sdsmt-robotics/Controller/README.md

# ARCHIVED. USE GITLAB.

# Controller
Repo is used to document all the iterations for the controller
