sdsmt-robotics/Controller/Eagle/Board.pdf

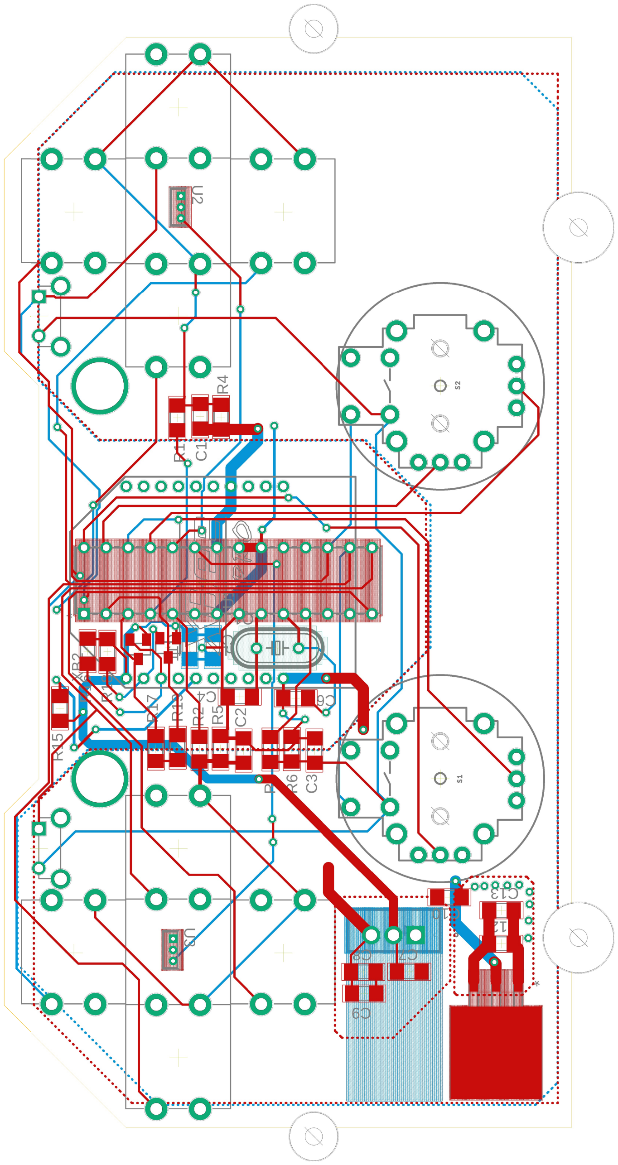
[picture p1: figure]
