sdsmt-robotics/Controller/3D/12x12 - Colored.PNG

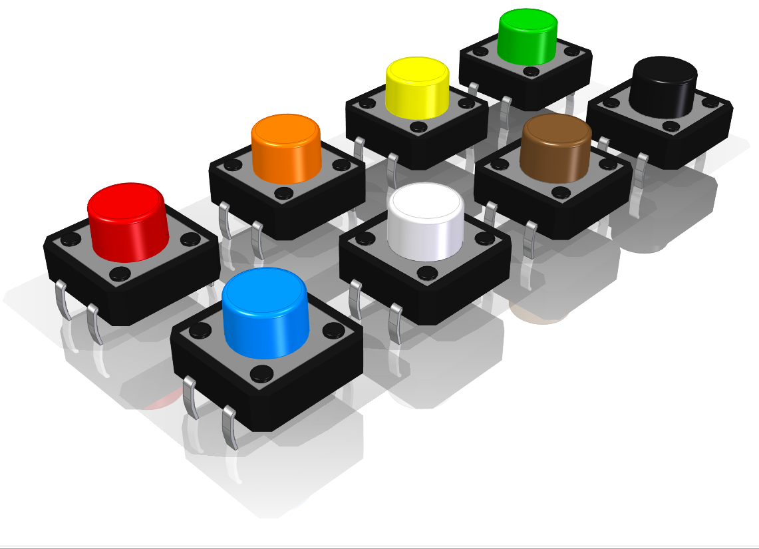
3D/12x12 - Colored.PNG
