sdsmt-robotics/Controller/2019-10-24_21-24-13/STEP/TS3B-L.step

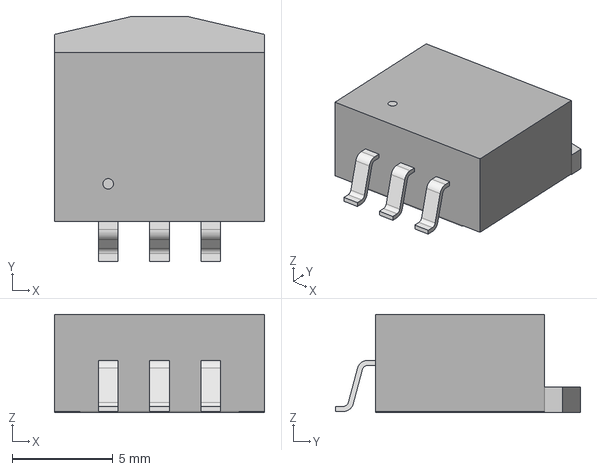
[picture p3: CAD file, 2019-10-24]
2019-10-24_21-24-13/STEP/TS3B-L.step
10.4 x 12.1 x 4.85 mm
