sdsmt-robotics/Controller/3D/Tactal Switch - THRU(12mmx12mmx8mm)-Brown.stp

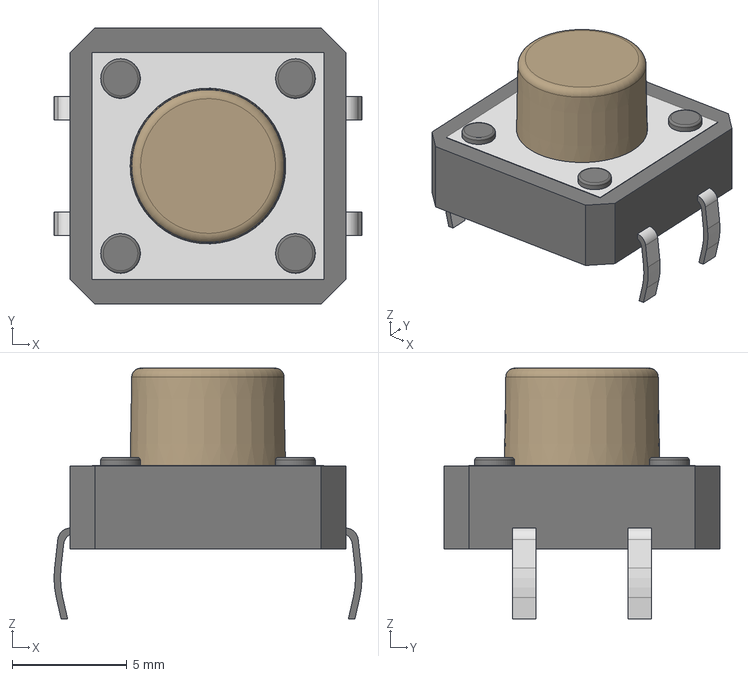
[picture p4: CAD file, 2019-10-19]
3D/Tactal Switch - THRU(12mmx12mmx8mm)-Brown.stp
13.4 x 12.0 x 10.9 mm
