sdsmt-robotics/Controller/3D/BSS138_D87Z--3DModel-STEP-56544.STEP

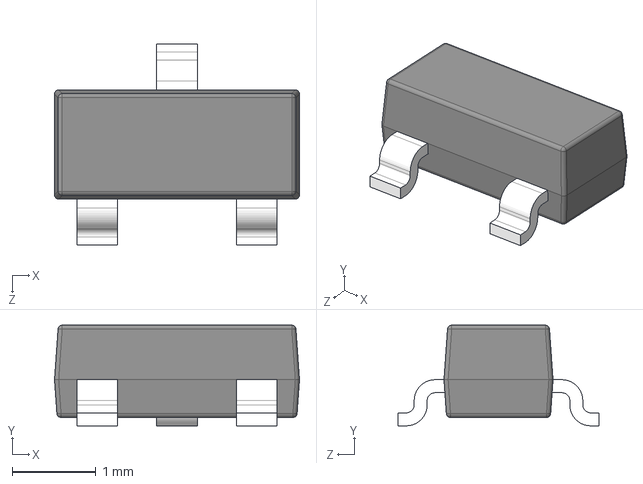
[picture p5: CAD file, 2019-10-19]
3D/BSS138_D87Z--3DModel-STEP-56544.STEP
2.92 x 1.20 x 2.40 mm
