sdsmt-robotics/Controller/3D/XBee Pro 60mW.STEP

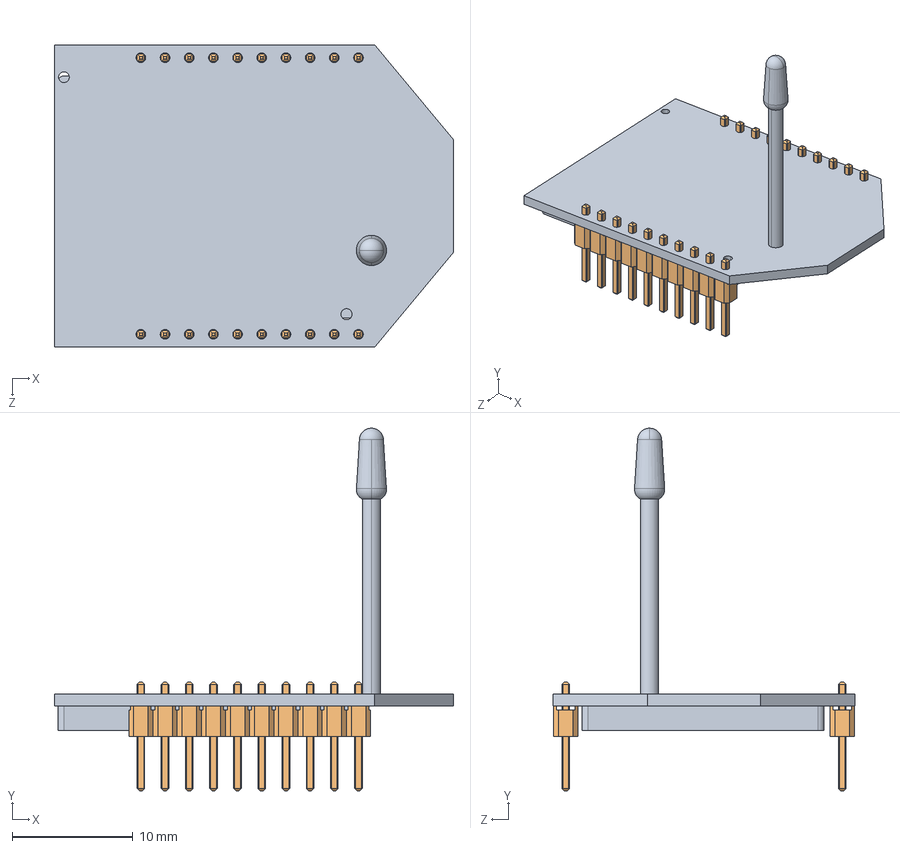
[picture p6: CAD file, 2019-10-19]
3D/XBee Pro 60mW.STEP
33.0 x 30.0 x 25.0 mm
XBee Pro 60mW PCB
10x Pinheader Male x 2
