sdsmt-robotics/Controller/3D/RKJXV1224005.STEP

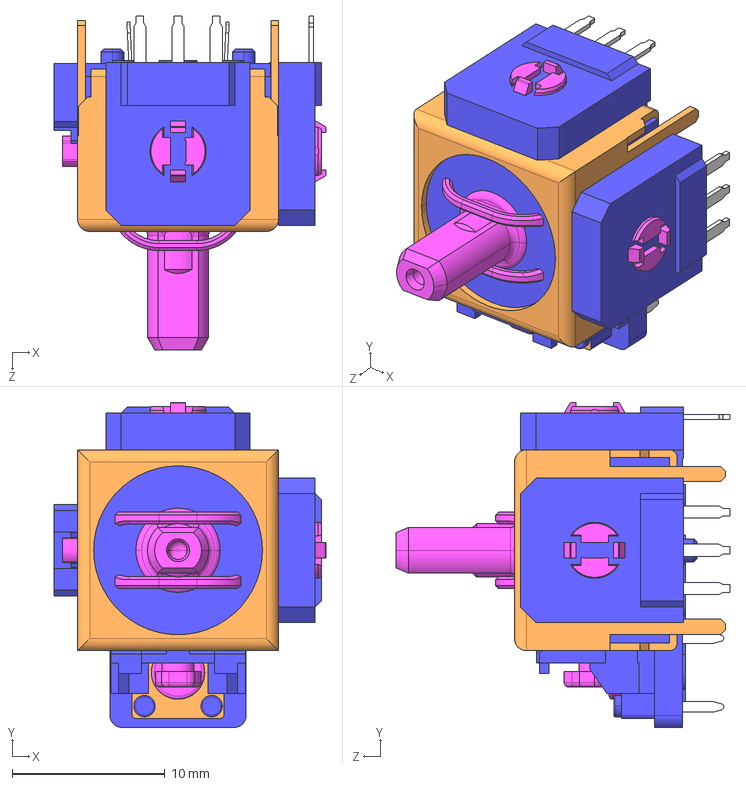
[picture p7: CAD file, 2019-10-11]
3D/RKJXV1224005.STEP
17.8 x 21.3 x 21.9 mm
