sdsmt-robotics/Controller/(list of files, cad)

Other CAD files:
2019-10-24_21-24-13/STEP/TS3B.step
2019-10-24_21-24-13/STEP/TS3B-M.step
3D/Tactal Switch - THRU(12mmx12mmx8mm)-Blue.stp
3D/Tactal Switch - THRU(12mmx12mmx8mm)-Green.stp
3D/Tactal Switch - THRU(12mmx12mmx8mm)-White.stp
3D/Tactal Switch - THRU(12mmx12mmx8mm)-Black.stp
3D/Tactal Switch - THRU(12mmx12mmx8mm)-Orange.stp
3D/Tactal Switch - THRU(12mmx12mmx8mm)-Red.stp
3D/Tactal Switch - THRU(12mmx12mmx8mm)-Yellow.stp
