sdsmt-robotics/Controller/Eagle/Schematic.pdf

A

A

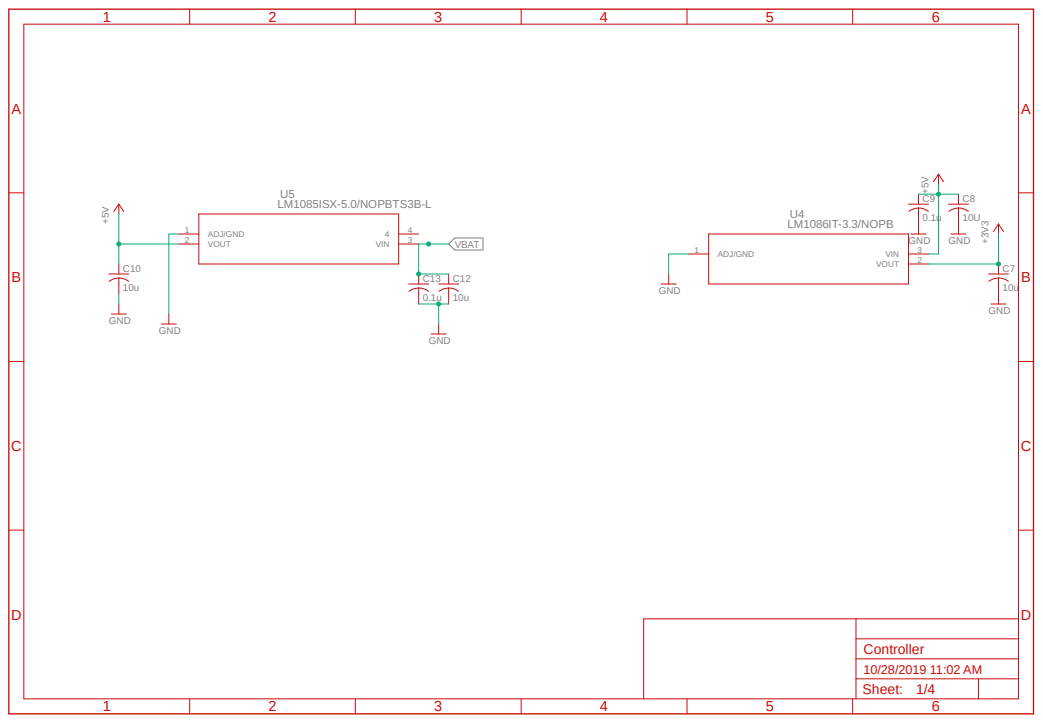
[picture p8: page 1]

## ATMEGA328-PU +5V

A

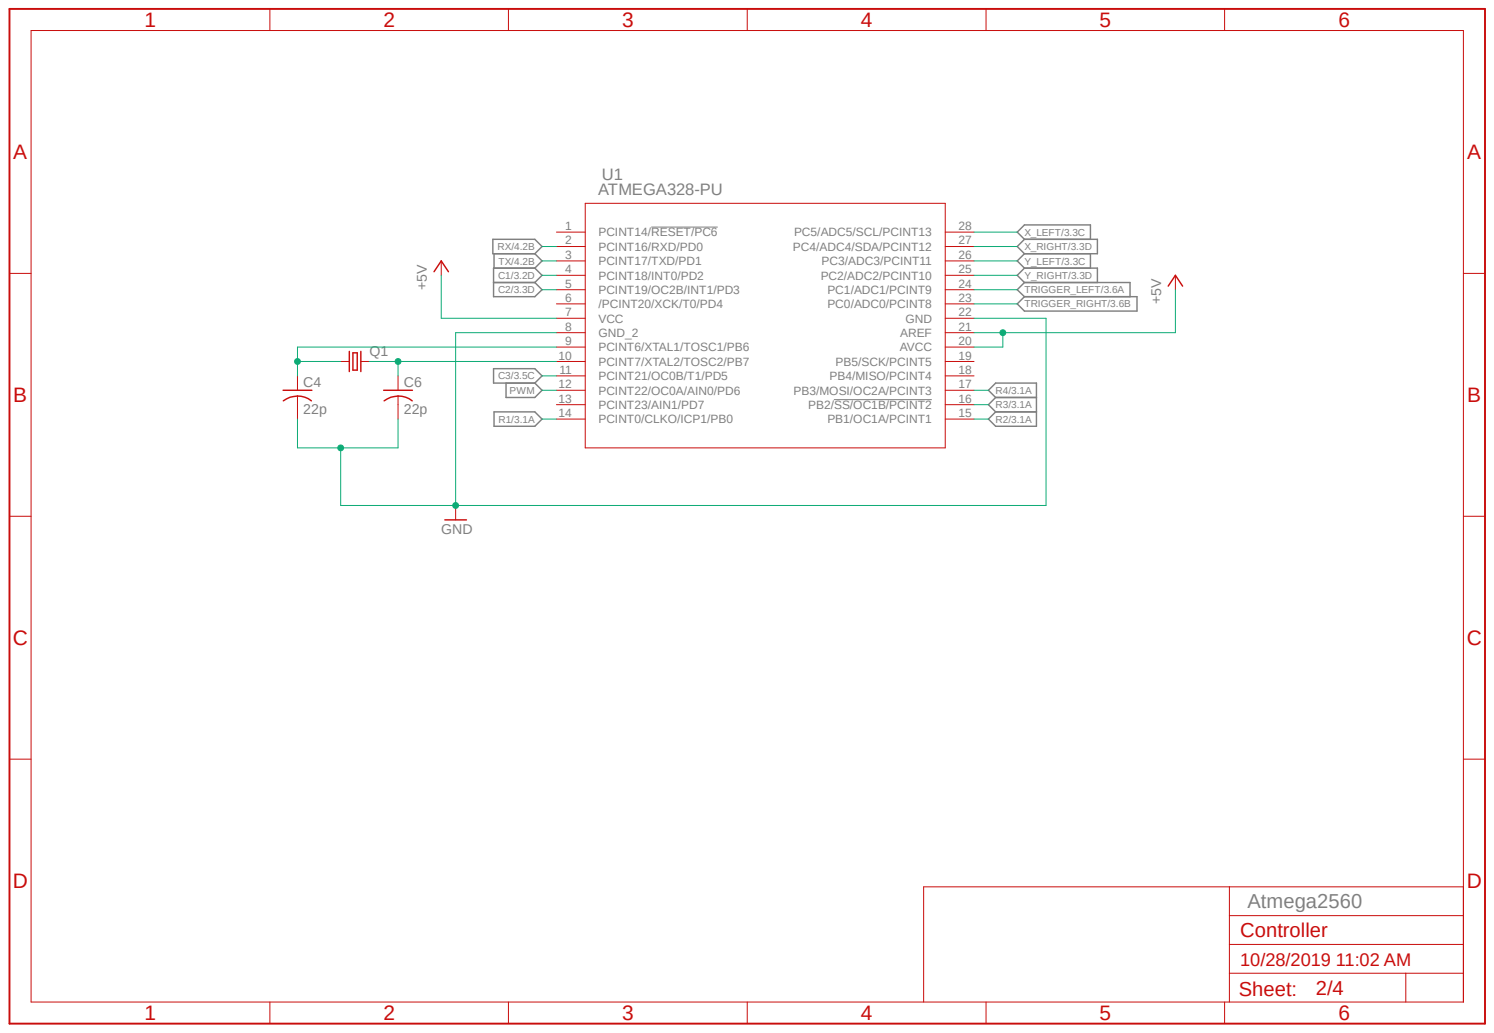
[picture p9: page 2]
Atmega2560; GND; PCINT14/RESET/PC6 1; PCINT16/RXD/PD0 2; PCINT17/TXD/PD1 3; PCINT18/INT0/PD2 4; PCINT19/OC2B/INT1/PD3 5; /PCINT20/XCK/T0/PD4 6; VCC 7; GND_2 8; PCINT6/XTAL1/TOSC1/PB6 9; PCINT7/XTAL2/TOSC2/PB7 10; PCINT21/OC0B/T1/PD5 11; PCINT22/OC0A/AIN0/PD6 12; PCINT23/AIN1/PD7 13; PCINT0/CLKO/ICP1/PB0 14; PB1/OC1A/PCINT1; 15 PB2/SS/OC1B/PCINT2; 16 PB3/MOSI/OC2A/PCINT3; 17 PB4/MISO/PCINT4; 18 PB5/SCK/PCINT5; 19 AVCC; 20 AREF; 21 GND; 22 PC0/ADC0/PCINT8; 23 PC1/ADC1/PCINT9; 24 PC2/ADC2/PCINT10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

## DRV5053VAQLPGM

## DRV5053VAQLPGM ⁺⁵V +5V

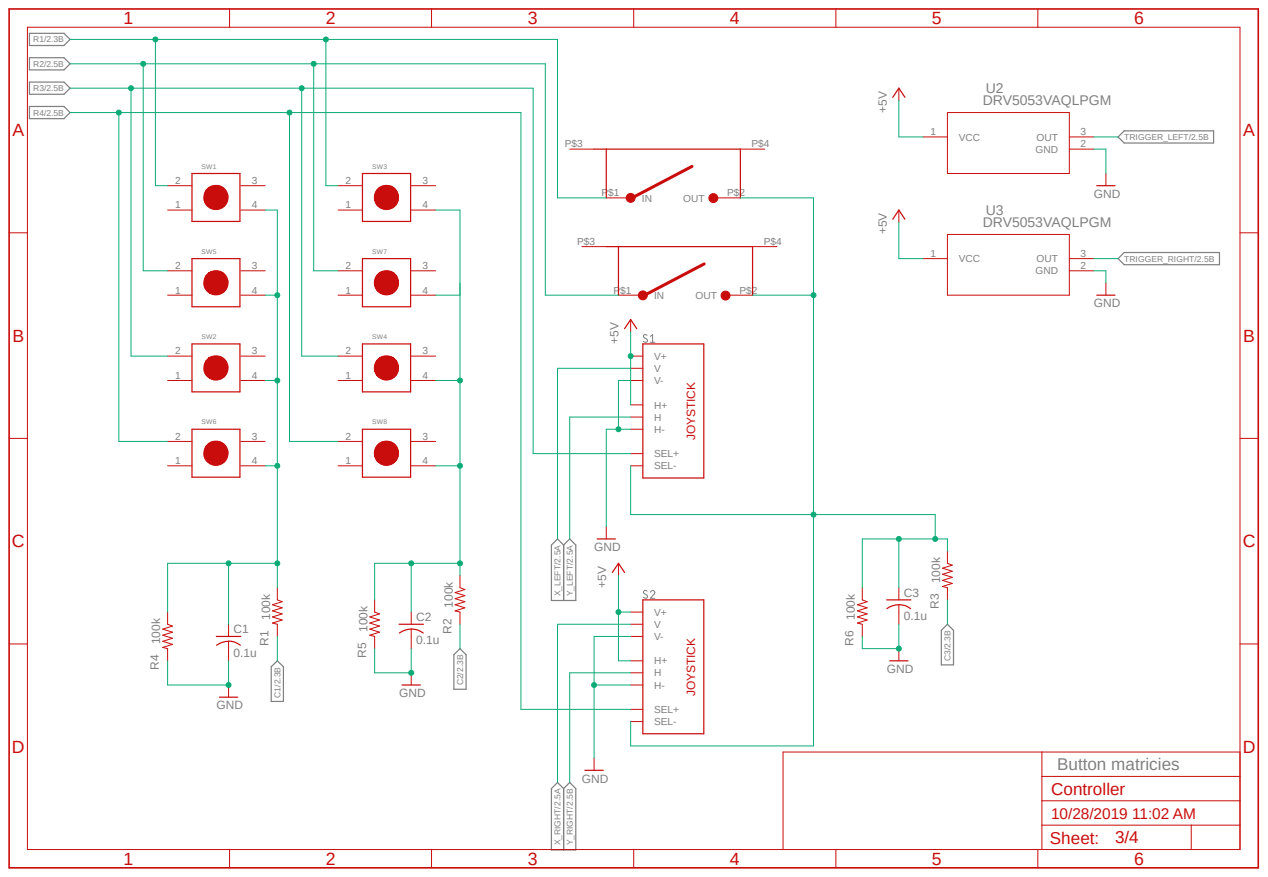
[picture p10: page 3]

Sheet: ABCD | 1 | 2 | 3 | 4 | 5 | 6 | ABCD 1 | 2 | 3 | 4 | 5 | 6

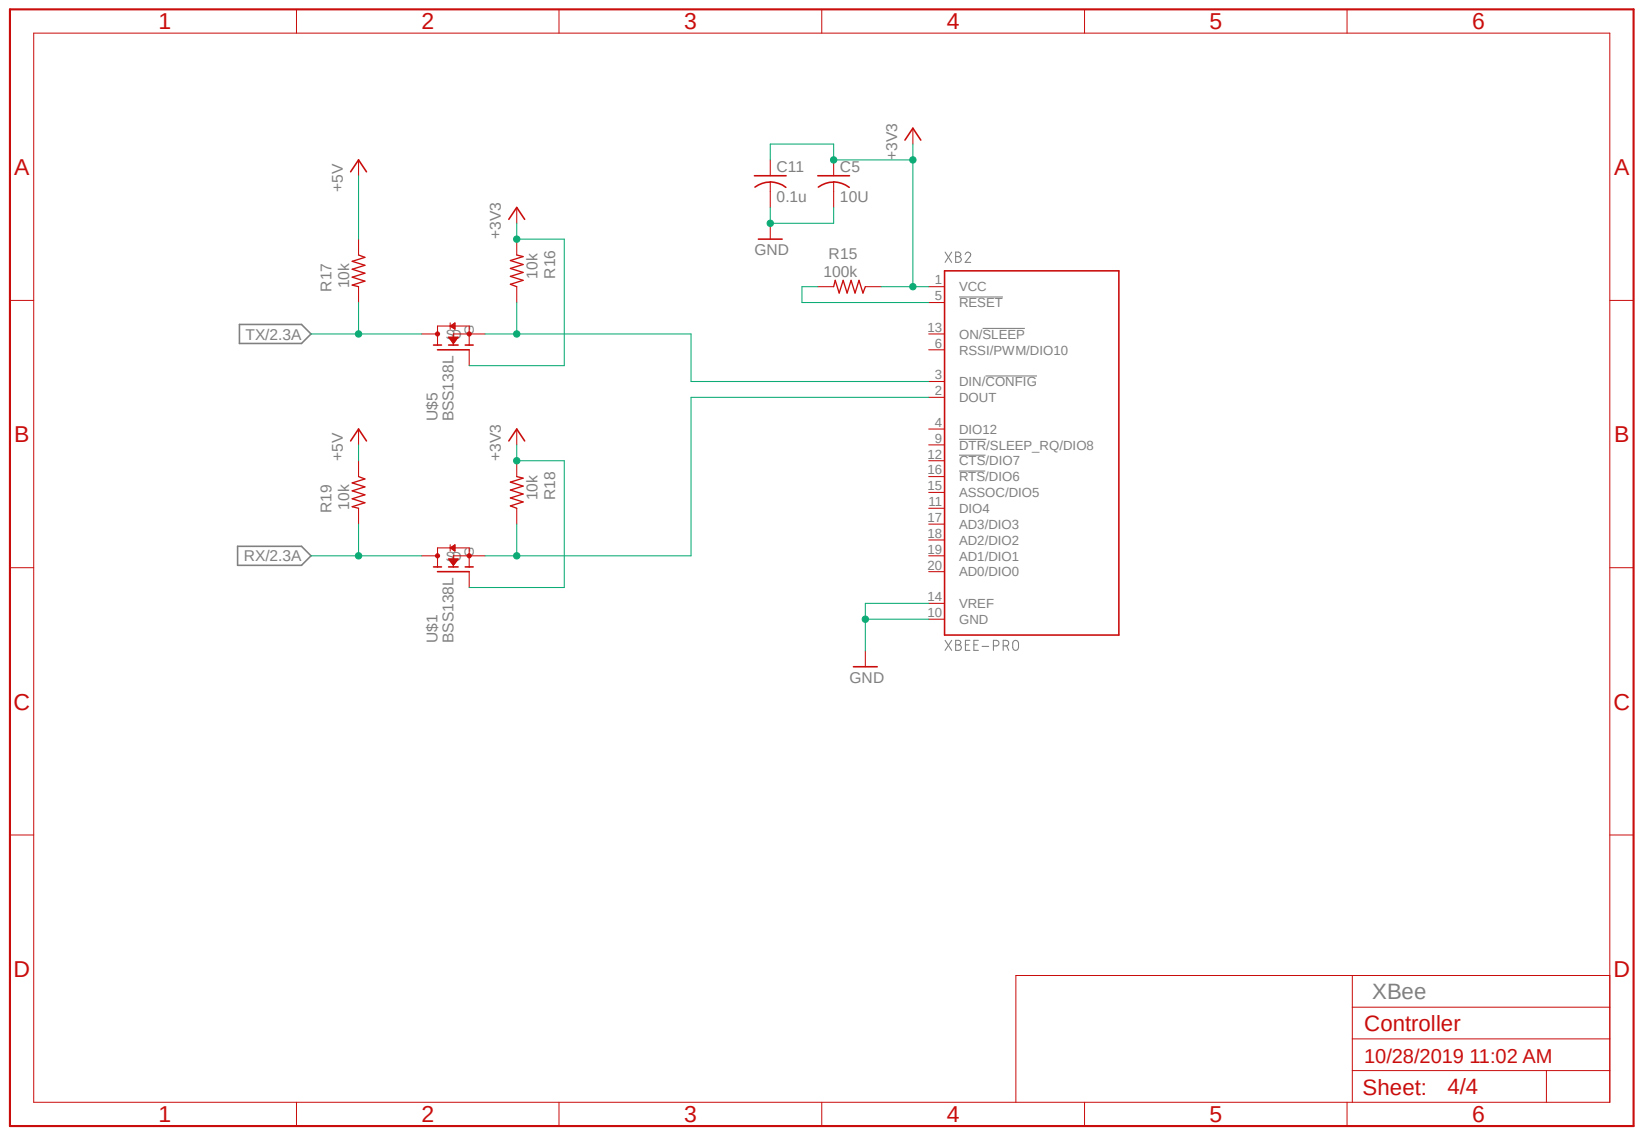
[picture p11: page 4]
XBee; +3V³ BSS¹³⁸L; BSS¹³⁸L; GND; VCC 1; DOUT 2; DIN/CONFIG 3; DIO12 4; RESET 5; RSSI/PWM/DIO10 6; DTR/SLEEP_RQ/DIO8 9; GND 10; DIO4 11; CTS/DIO7 12; ON/SLEEP 13; VREF 14; ASSOC/DIO5 15; RTS/DIO6 16; AD3/DIO3 17; AD2/DIO2 18; AD1/DIO1 19; AD0/DIO0 20; R¹⁶ R¹⁷; R¹⁸ R¹⁹; Controller
