sdsmt-robotics/Controller/Controller.pdf

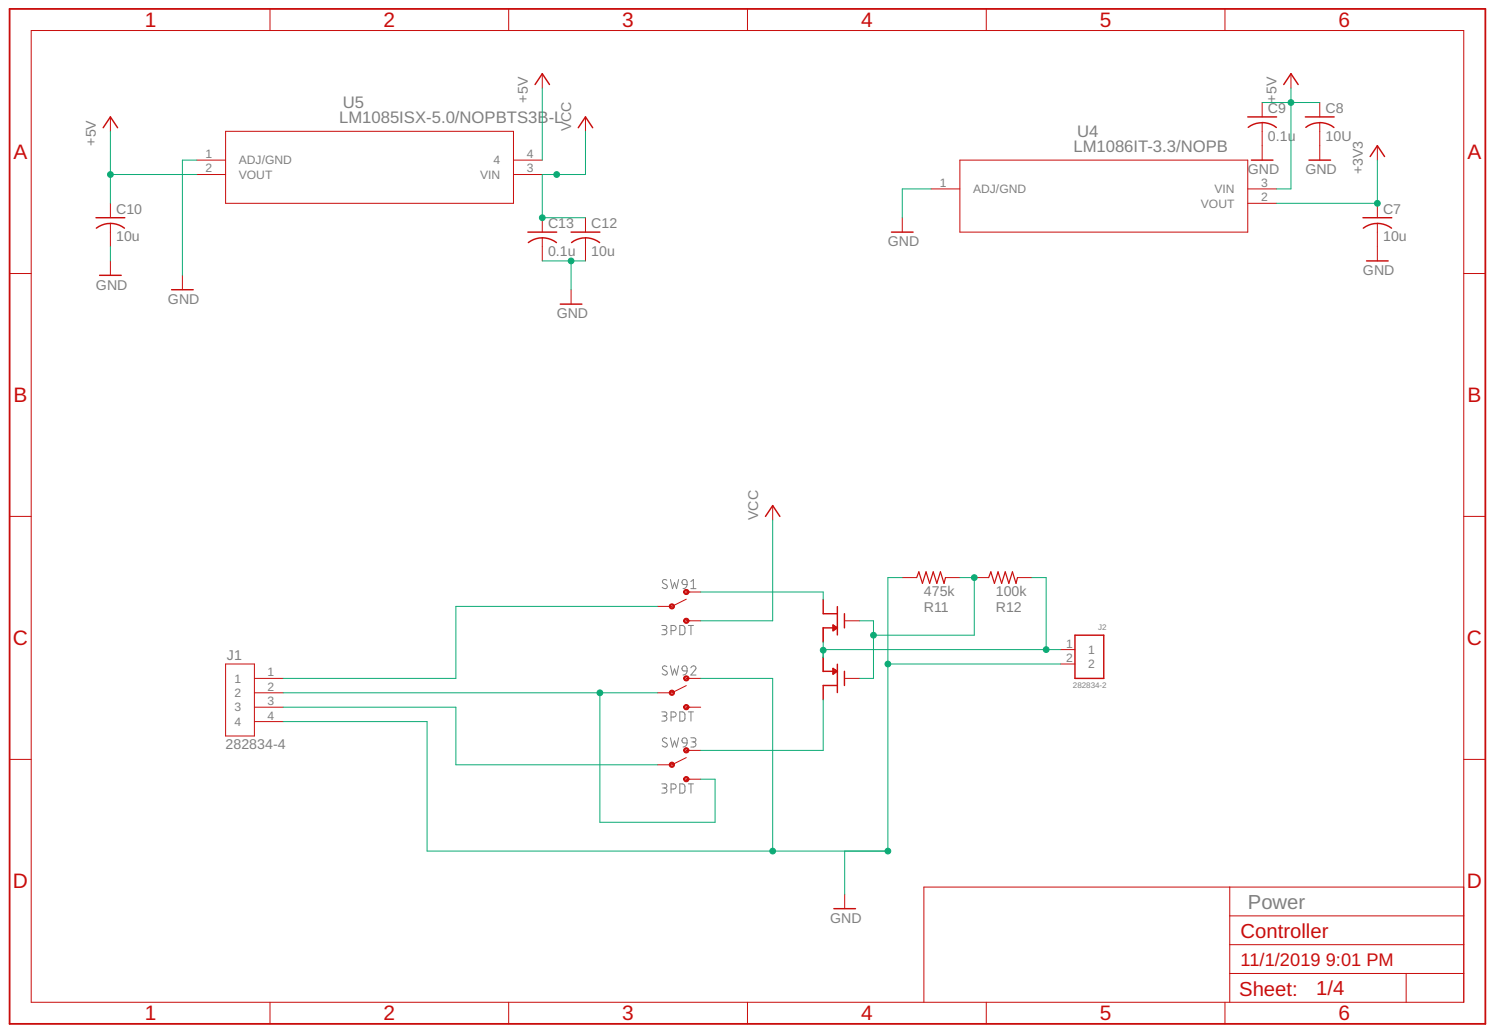
[picture p12: page 1]

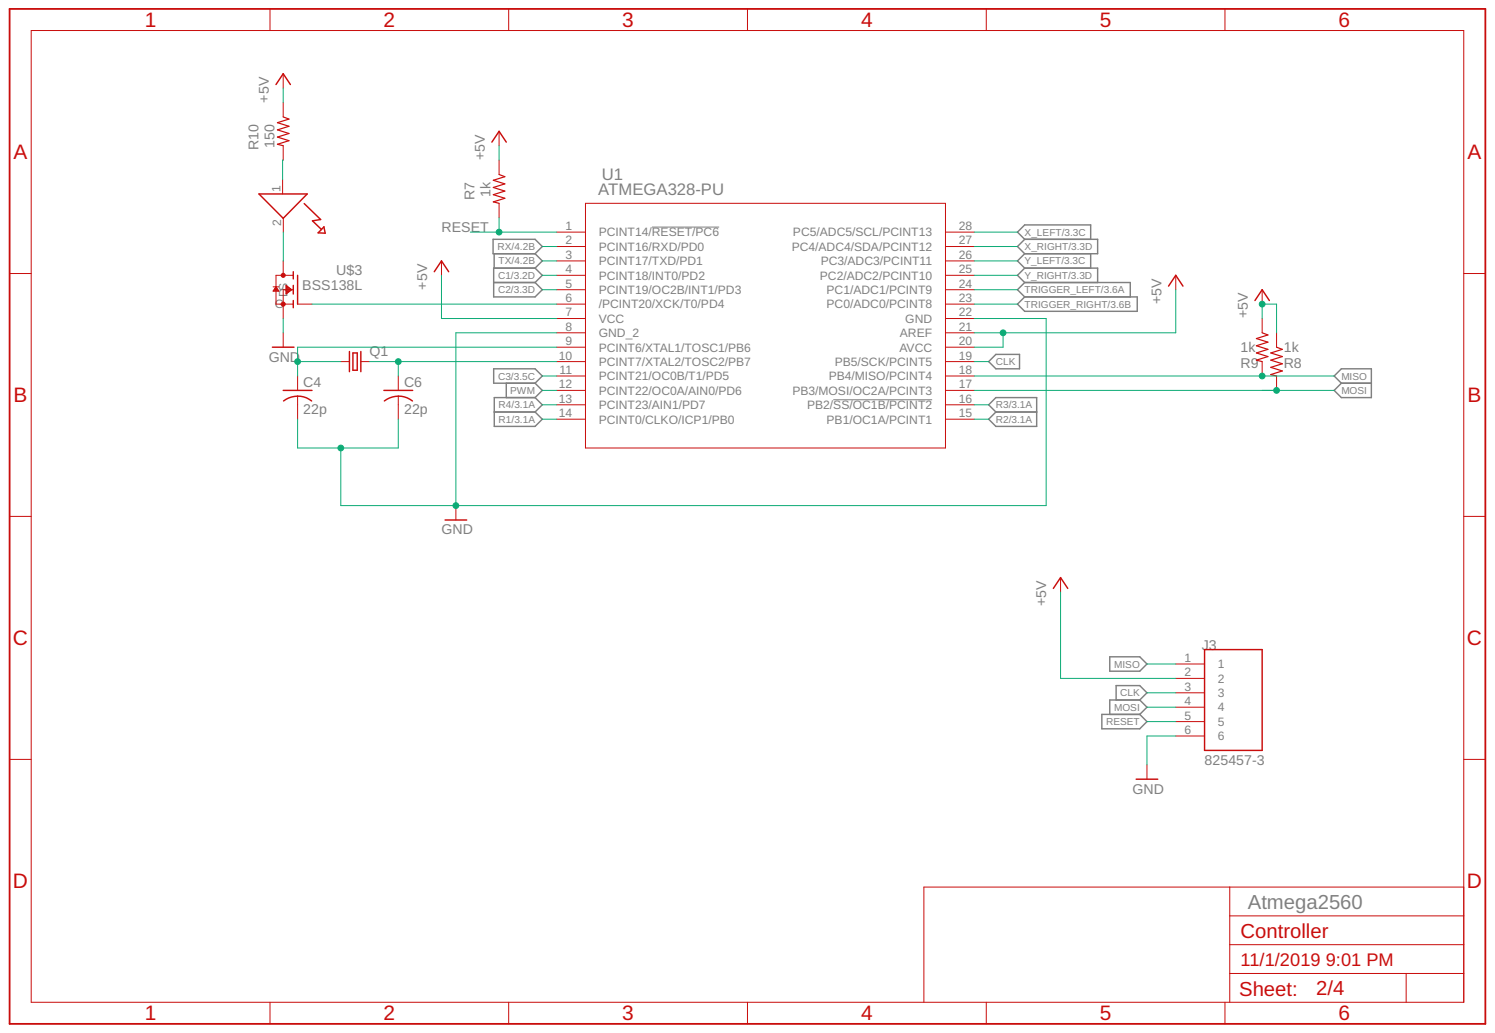
[picture p13: page 2]

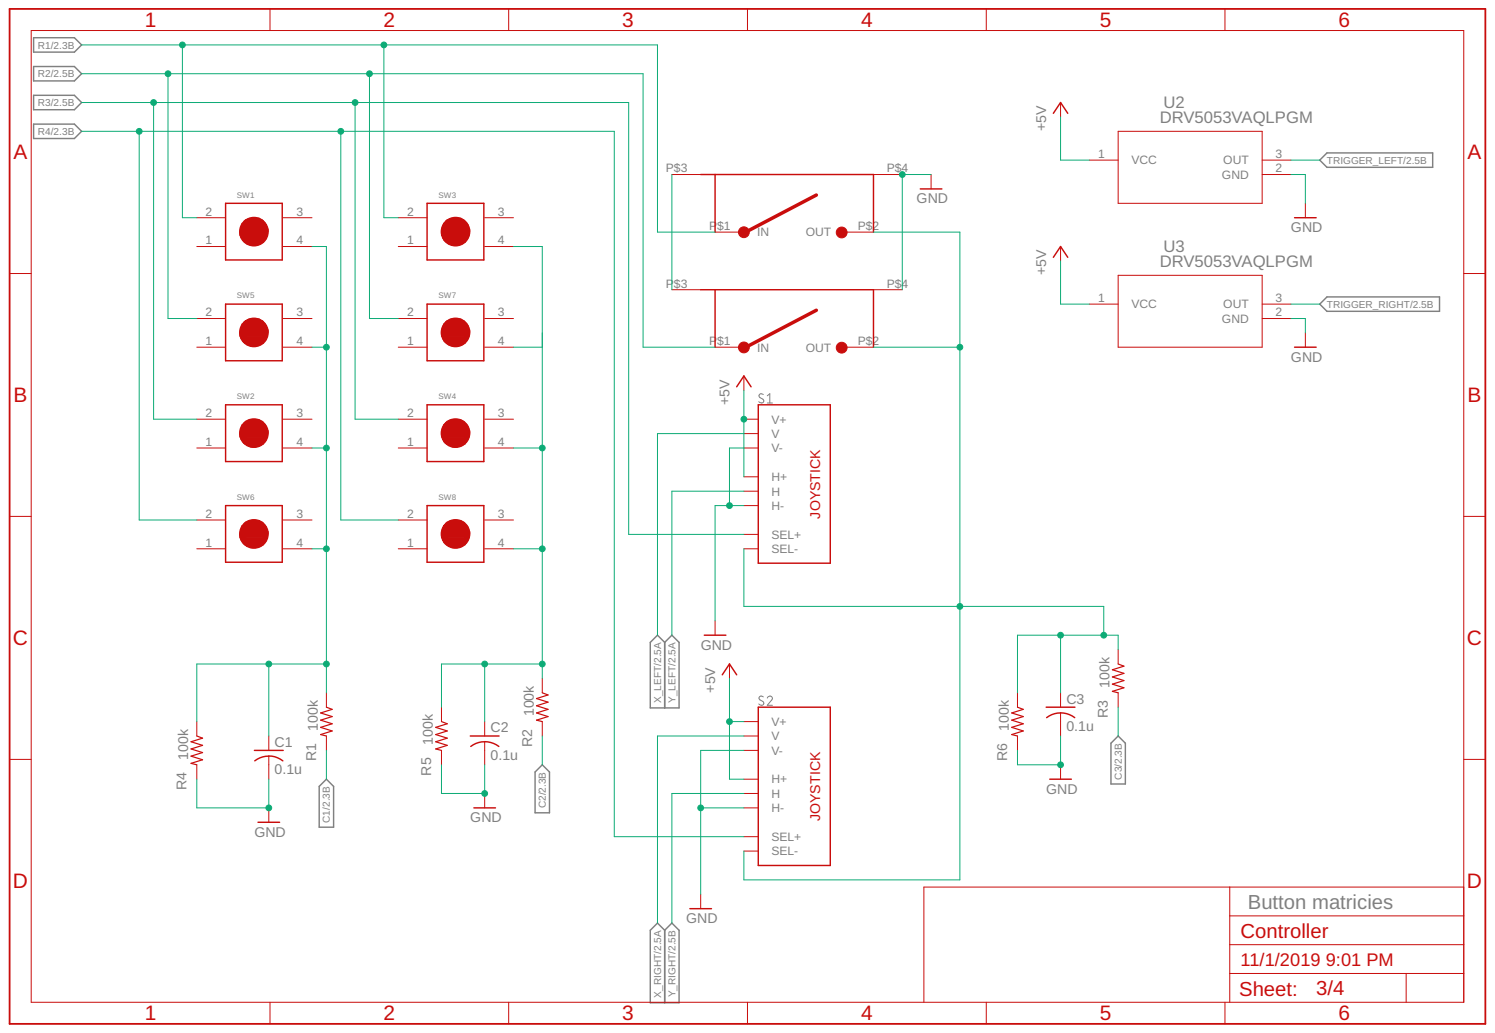
[picture p14: page 3]

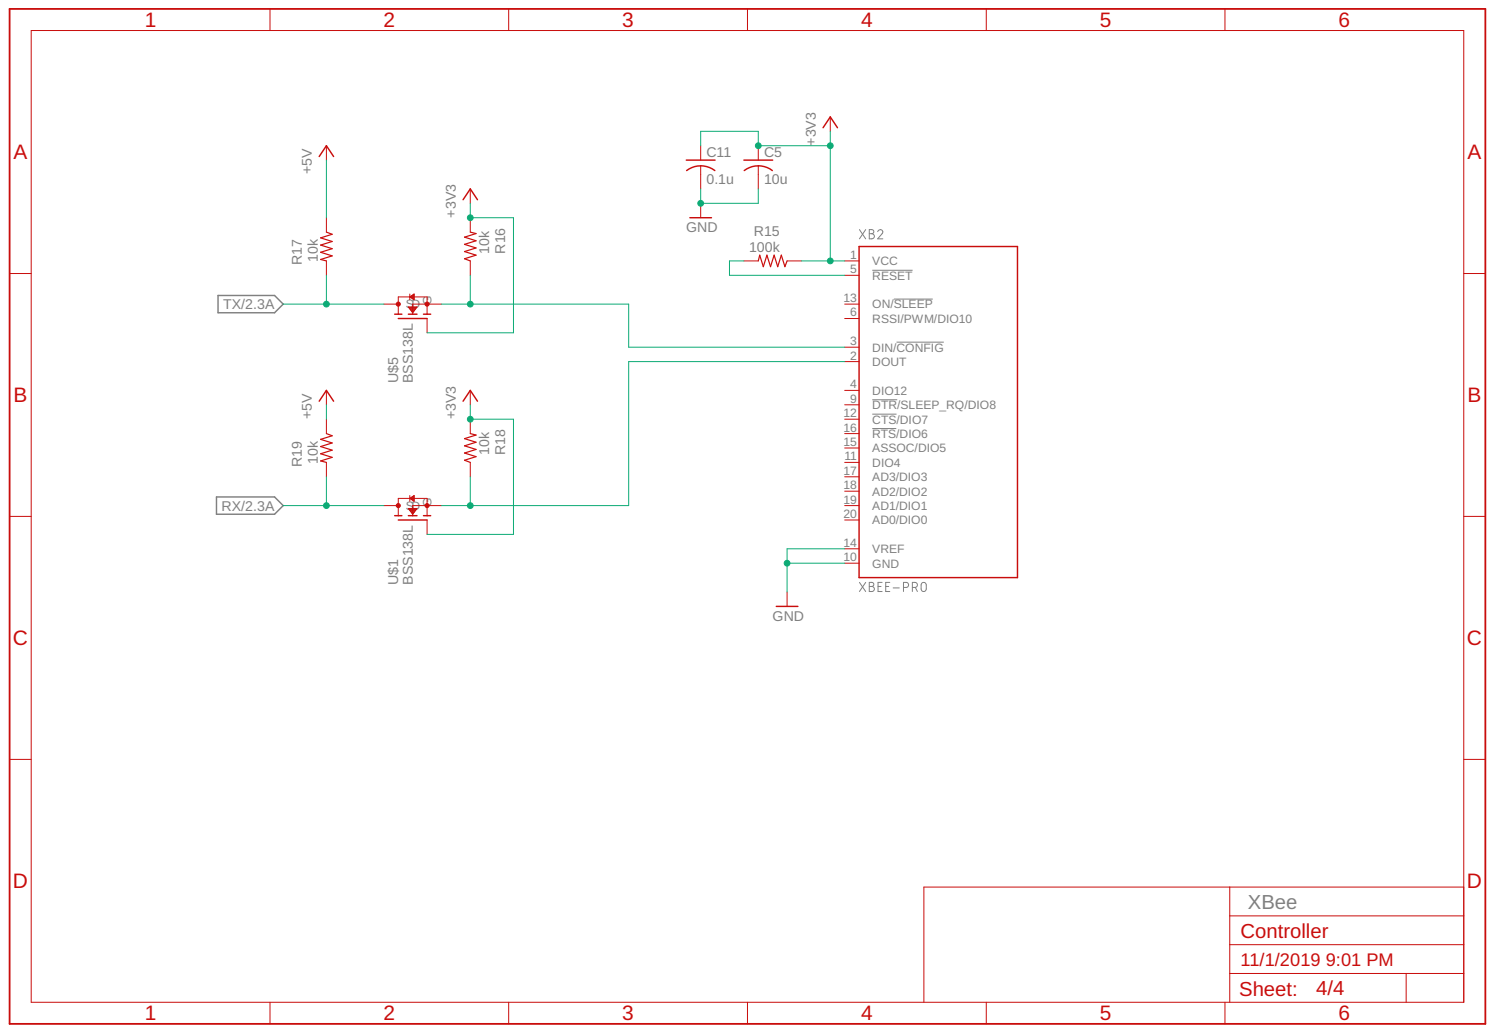
[picture p15: page 4]
