sdsmt-robotics/Controller/Controller.brd

## EAGLE design Controller.brd (2019-11-21)

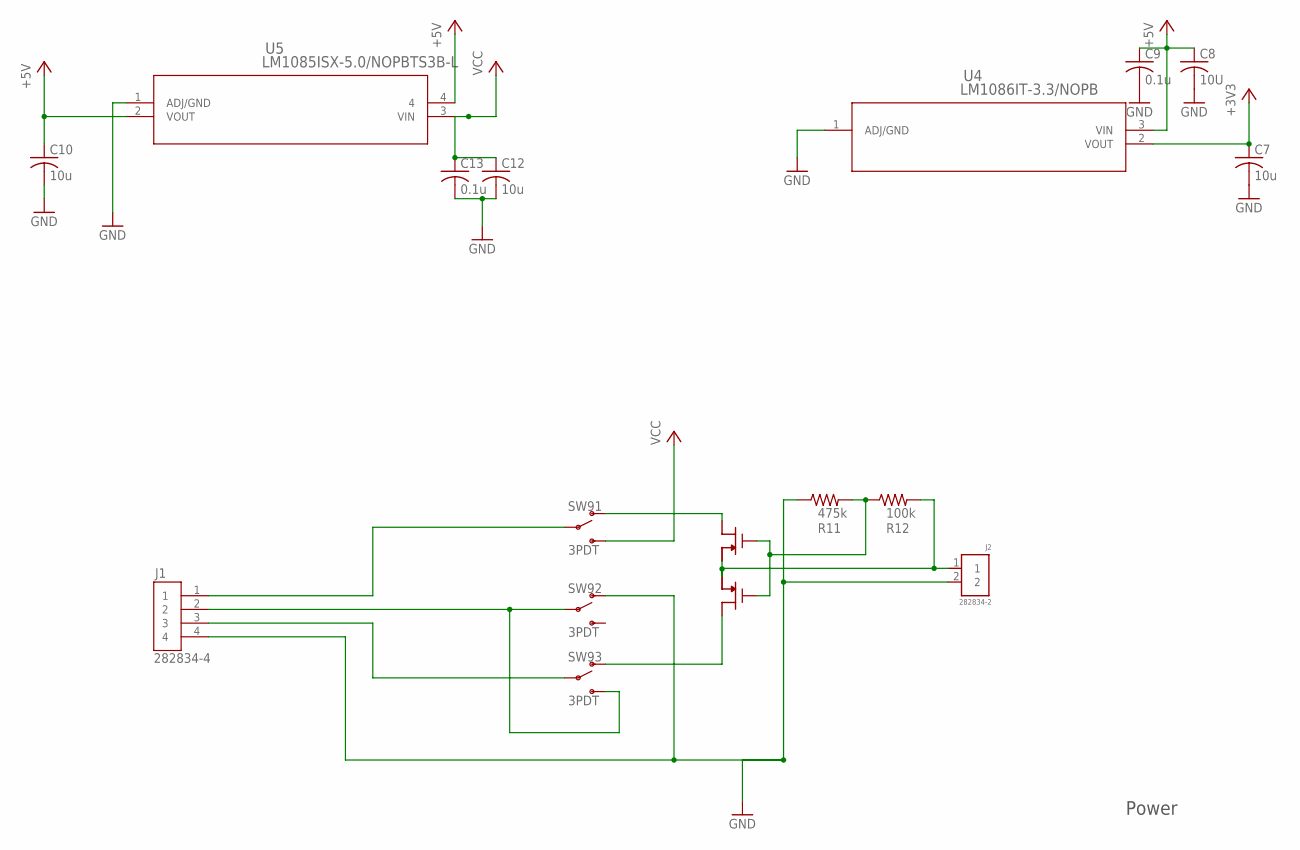
[picture p16: schematic Controller.sch, sheet 1]

Parts:
C7, C10, C12: 10u; C1206
C8: 10U; C1206
C9, C13: 0.1u; C1206
J1: 282834-4; HDRV4W85P254_4X1_1062X650X1000
J2: 282834-2; CONN_282834-2
R11: 475k; R1206
R12: 100k; R1206
SW9: 3PDT
U4: LM1086IT-3.3/NOPB; T03B
U5: LM1085ISX-5.0/NOPBTS3B-L; TS3B-L
U6: SSM6P40TULFCT-ND; SMD6

Connections:
+3V3: C7.1, U4.2 (VOUT); also elsewhere on the board
+5V: C8.1, C9.1, C10.1, U4.3 (VIN), U5.2 (VOUT), U5.4; also elsewhere on the board
GND: C7.2, C8.2, C9.2, C10.2, C12.2, C13.2, J1.4, J2.2, R11.1, SW9.T21 (O), U4.1 (ADJ/GND), U5.1 (ADJ/GND); also elsewhere on the board
unnamed: J1.1, SW9.P1
unnamed: J1.2, SW9.P2, SW9.T32 (S)
unnamed: J1.3, SW9.P3
unnamed: SW9.T31 (O), U6.P$3 (D)
unnamed: J2.1, R12.2, U6.P$1 (S), U6.P$4 (S)
unnamed: SW9.T11 (O), U6.P$6 (D)
unnamed: R11.2, R12.1, U6.P$2 (G), U6.P$5 (G)
VCC: C12.1, C13.1, SW9.T12 (S), U5.3 (VIN)

Notes on the sheet:
Power

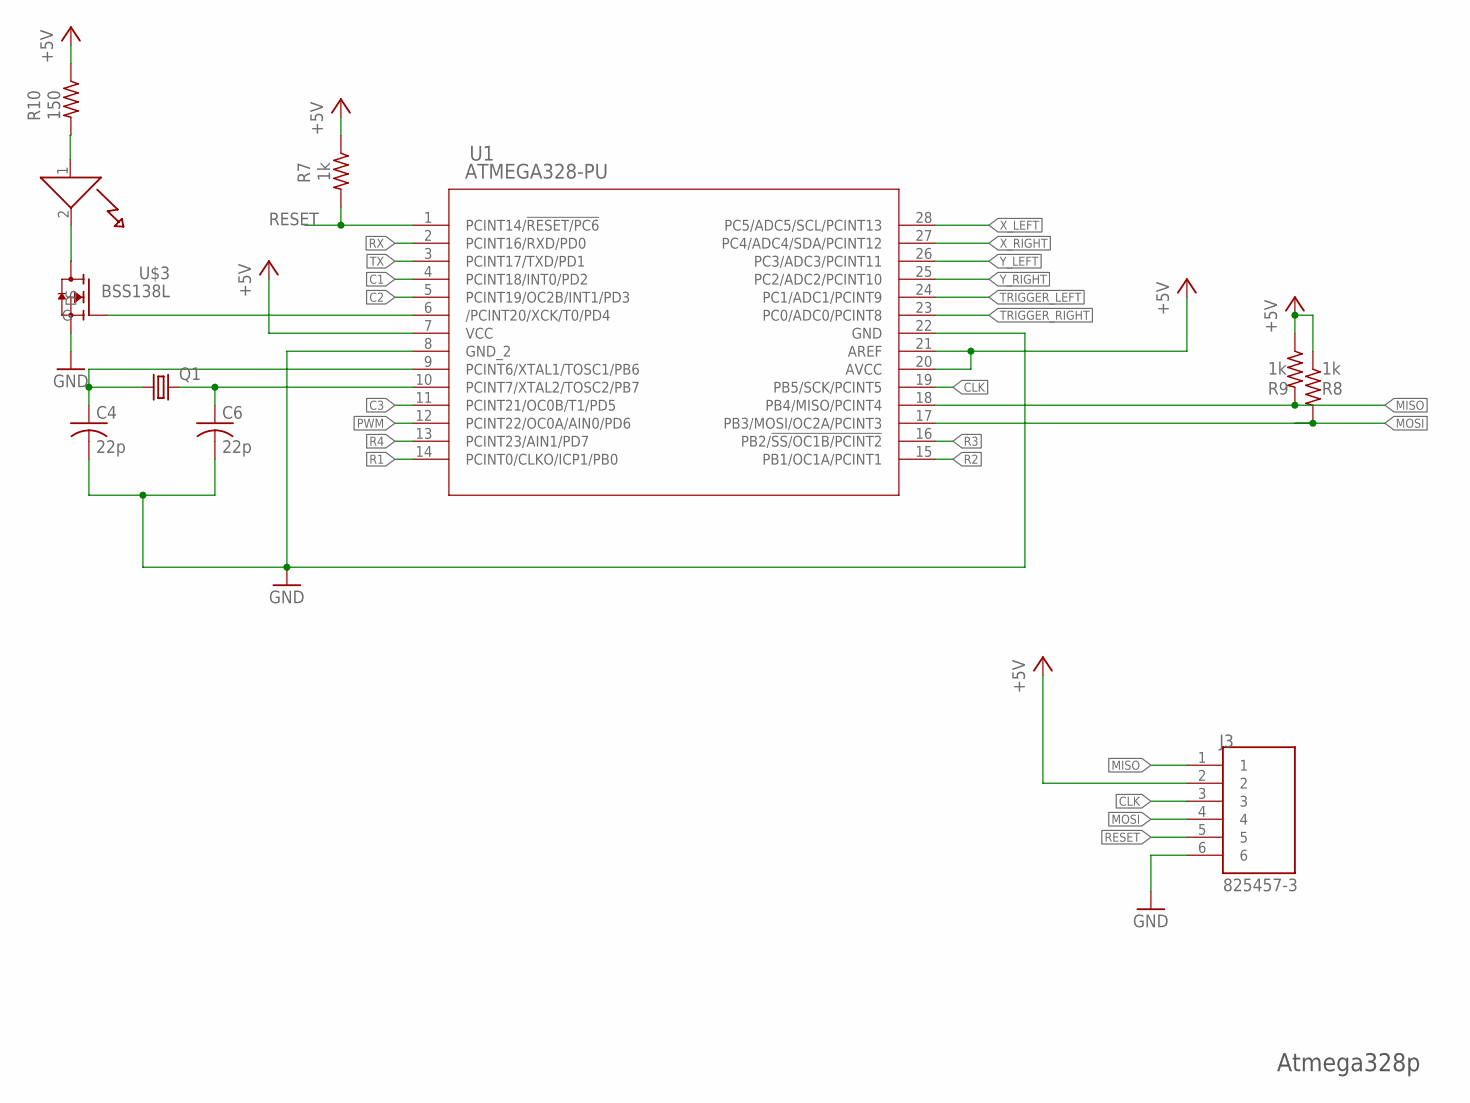
[picture p17: schematic Controller.sch, sheet 2]

Parts:
C4, C6: 22p; C1206
J3: 825457-3; TE_825457-3
Q1: CRYSTALHC49S; HC49/S
R7, R8, R9: 1k; R1206
R10: 150; R1206
U1: ATMEGA328-PU; 28P3
U$2: LED; R1206W
U$3: BSS138L

Connections:
+5V: J3.2, R7.1, R8.1, R9.1, R10.1, U1.7 (VCC), U1.20 (AVCC), U1.21 (AREF); also elsewhere on the board
C1: U1.4 (PCINT18/INT0/PD2); also elsewhere on the board
C2: U1.5 (PCINT19/OC2B/INT1/PD3); also elsewhere on the board
C3: U1.11 (PCINT21/OC0B/T1/PD5); also elsewhere on the board
CLK: J3.3, U1.19 (PB5/SCK/PCINT5)
GND: C4.2, C6.2, J3.6, U1.8 (GND_2), U1.22 (GND), U$3.S; also elsewhere on the board
MISO: J3.1, R9.2, U1.18 (PB4/MISO/PCINT4)
MOSI: J3.4, R8.2, U1.17 (PB3/MOSI/OC2A/PCINT3)
unnamed: C4.1, Q1.1, U1.9 (PCINT6/XTAL1/TOSC1/PB6)
unnamed: C6.1, Q1.2, U1.10 (PCINT7/XTAL2/TOSC2/PB7)
unnamed: U1.6 (/PCINT20/XCK/T0/PD4), U$3.G
unnamed: U$2.2, U$3.D
unnamed: R10.2, U$2.1
PWM: U1.12 (PCINT22/OC0A/AIN0/PD6)
R1: U1.14 (PCINT0/CLKO/ICP1/PB0); also elsewhere on the board
R2: U1.15 (PB1/OC1A/PCINT1); also elsewhere on the board
R3: U1.16 (PB2/!SS/OC1B/PCINT2); also elsewhere on the board
R4: U1.13 (PCINT23/AIN1/PD7); also elsewhere on the board
RESET: J3.5, R7.2, U1.1 (PCINT14/!RESET/PC6)
RX: U1.2 (PCINT16/RXD/PD0); also elsewhere on the board
TRIGGER_LEFT: U1.24 (PC1/ADC1/PCINT9); also elsewhere on the board
TRIGGER_RIGHT: U1.23 (PC0/ADC0/PCINT8); also elsewhere on the board
TX: U1.3 (PCINT17/TXD/PD1); also elsewhere on the board
X_LEFT: U1.28 (PC5/ADC5/SCL/PCINT13); also elsewhere on the board
X_RIGHT: U1.27 (PC4/ADC4/SDA/PCINT12); also elsewhere on the board
Y_LEFT: U1.26 (PC3/ADC3/PCINT11); also elsewhere on the board
Y_RIGHT: U1.25 (PC2/ADC2/PCINT10); also elsewhere on the board

Notes on the sheet:
Atmega328p

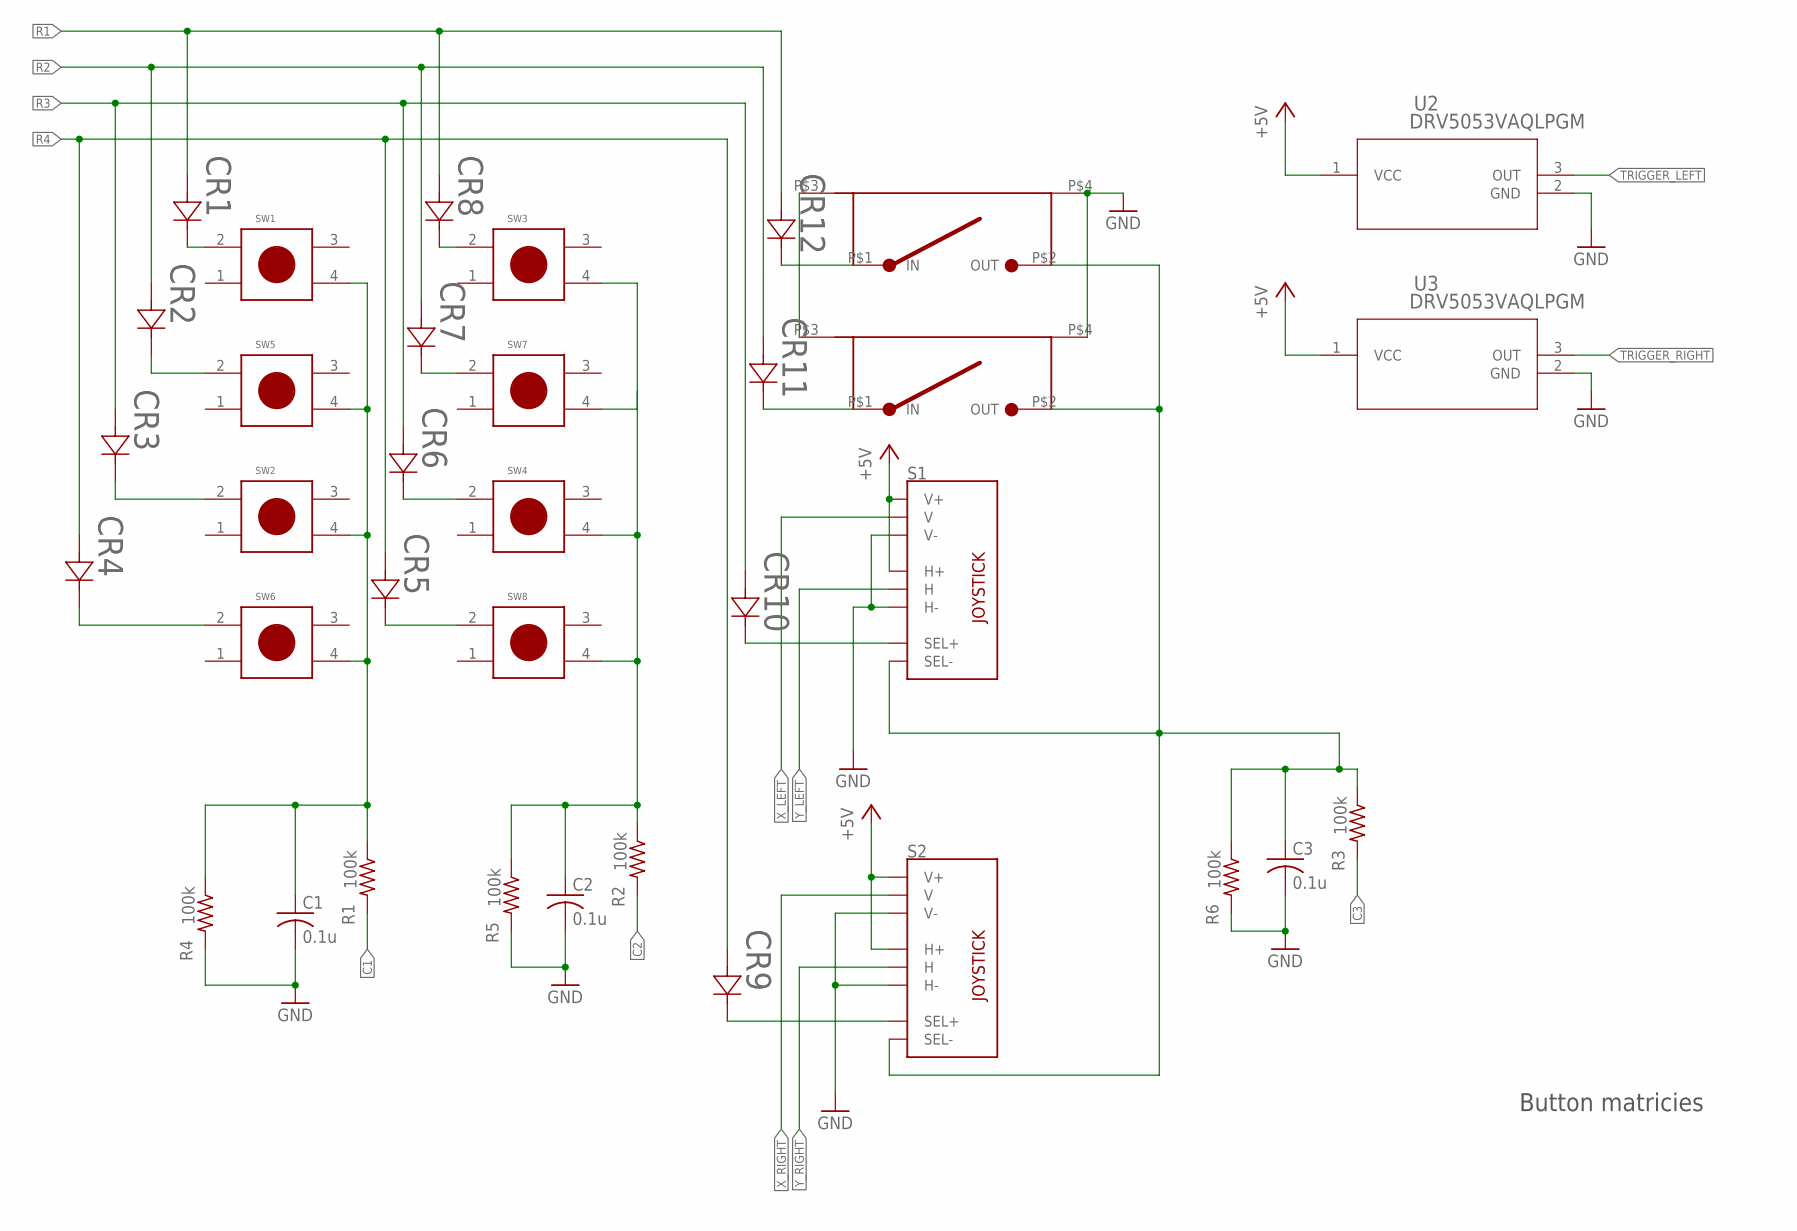
[picture p18: schematic Controller.sch, sheet 3]

Parts:
C1, C2, C3: 0.1u; C1206
CR1, CR2, CR3, CR4, CR5, CR6, CR7, CR8, CR9, CR10, CR11, CR12: MSS1P6-M3/89ADIODE_MSP3V3-M; DIODE_MSP3V3-M
R1, R2, R3, R4, R5, R6: 100k; R1206
S1, S2: THUMBPOINTER-RKJXV1224005
SW1, SW2, SW3, SW4, SW5, SW6, SW7, SW8: MULTICOLOR_BUTTON; PRT-14460
U2, U3: DRV5053VAQLPGM; LPG3
U$4, U$6: BUMPER_BUMPER

Connections:
$NC1: C1.1, R1.1, R4.1, SW1.4, SW2.4, SW5.4, SW6.4
+5V: S1.H1 (H+), S1.V1 (V+), S2.H1 (H+), S2.V1 (V+), U2.1 (VCC), U3.1 (VCC); also elsewhere on the board
C1: R1.2; also elsewhere on the board
C2: R2.2; also elsewhere on the board
C3: R3.2; also elsewhere on the board
GND: C1.2, C2.2, C3.2, R4.2, R5.2, R6.2, S1.H3 (H-), S1.V3 (V-), S2.H3 (H-), S2.V3 (V-), U2.2 (GND), U3.2 (GND), U$4.P$4 (GROUND), U$6.P$4 (GROUND); also elsewhere on the board
unnamed: CR4.1, SW6.2
unnamed: U$4.P$3 (GROUND1), U$6.P$3 (GROUND1)
unnamed: CR3.1, SW2.2
unnamed: CR2.1, SW5.2
unnamed: CR1.1, SW1.2
unnamed: CR7.1, SW7.2
unnamed: CR6.1, SW4.2
unnamed: CR5.1, SW8.2
unnamed: CR12.1, U$4.P$1 (IN)
unnamed: CR8.1, SW3.2
unnamed: CR11.1, U$6.P$1 (IN)
unnamed: CR10.1, S1.B1A (SEL+)
unnamed: CR9.1, S2.B1A (SEL+)
N$C2: C2.1, R2.1, R5.1, SW3.4, SW4.4, SW7.4, SW8.4
N$C3: C3.1, R3.1, R6.1, S1.B2A (SEL-), S2.B2A (SEL-), U$4.P$2 (OUT), U$6.P$2 (OUT)
R1: CR1.2, CR8.2, CR12.2; also elsewhere on the board
R2: CR2.2, CR7.2, CR11.2; also elsewhere on the board
R3: CR3.2, CR6.2, CR10.2; also elsewhere on the board
R4: CR4.2, CR5.2, CR9.2; also elsewhere on the board
TRIGGER_LEFT: U2.3 (OUT); also elsewhere on the board
TRIGGER_RIGHT: U3.3 (OUT); also elsewhere on the board
X_LEFT: S1.V2 (V); also elsewhere on the board
X_RIGHT: S2.V2 (V); also elsewhere on the board
Y_LEFT: S1.H2 (H); also elsewhere on the board
Y_RIGHT: S2.H2 (H); also elsewhere on the board

Notes on the sheet:
Button matricies

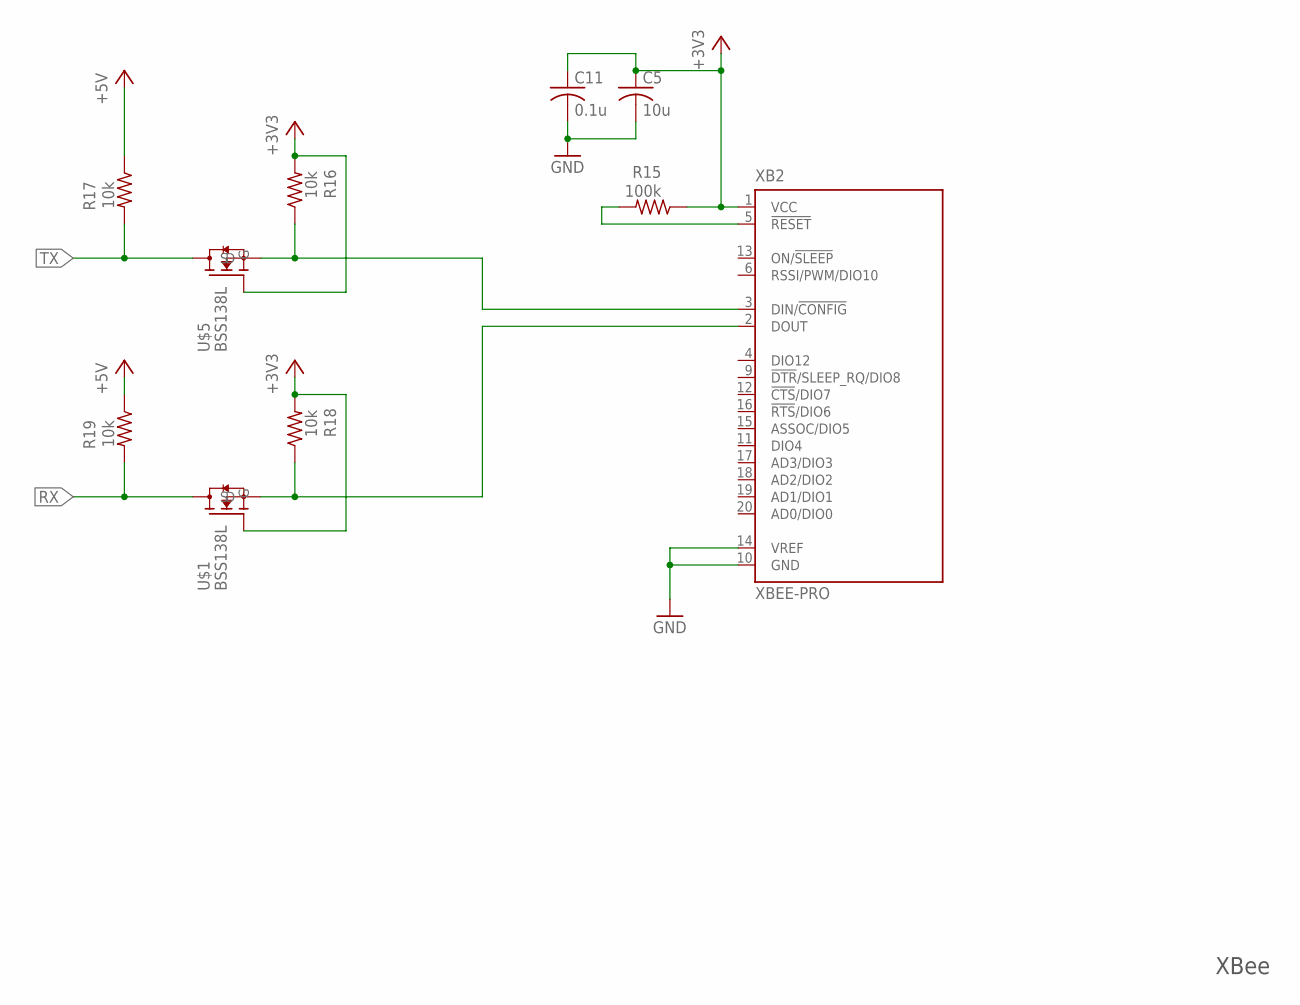
[picture p19: schematic Controller.sch, sheet 4]

Parts:
C5: 10u; C1206
C11: 0.1u; C1206
R15: 100k; R1206
R16, R17, R18, R19: 10k; R1206
U$1, U$5: BSS138L
XB2: XBEE-PRO

Connections:
+3V3: C5.1, C11.1, R15.1, R16.2, R18.2, U$1.G, U$5.G, XB2.1 (VCC); also elsewhere on the board
+5V: R17.1, R19.1; also elsewhere on the board
GND: C5.2, C11.2, XB2.10 (GND), XB2.14 (VREF); also elsewhere on the board
unnamed: R15.2, XB2.5 (!RESET)
unnamed: R16.1, U$5.S, XB2.3 (DIN/!CONFIG)
unnamed: R18.1, U$1.S, XB2.2 (DOUT)
RX: R19.2, U$1.D; also elsewhere on the board
TX: R17.2, U$5.D; also elsewhere on the board

Notes on the sheet:
XBee

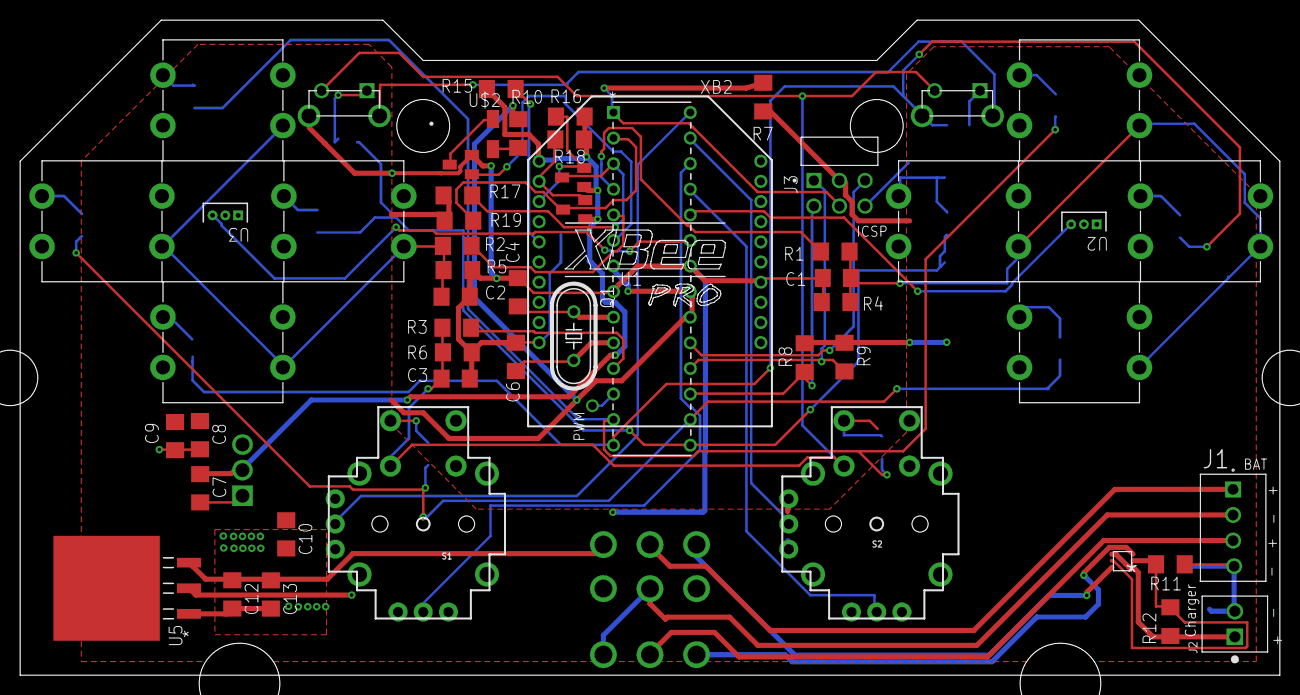
[picture p20: board Controller.brd from above]

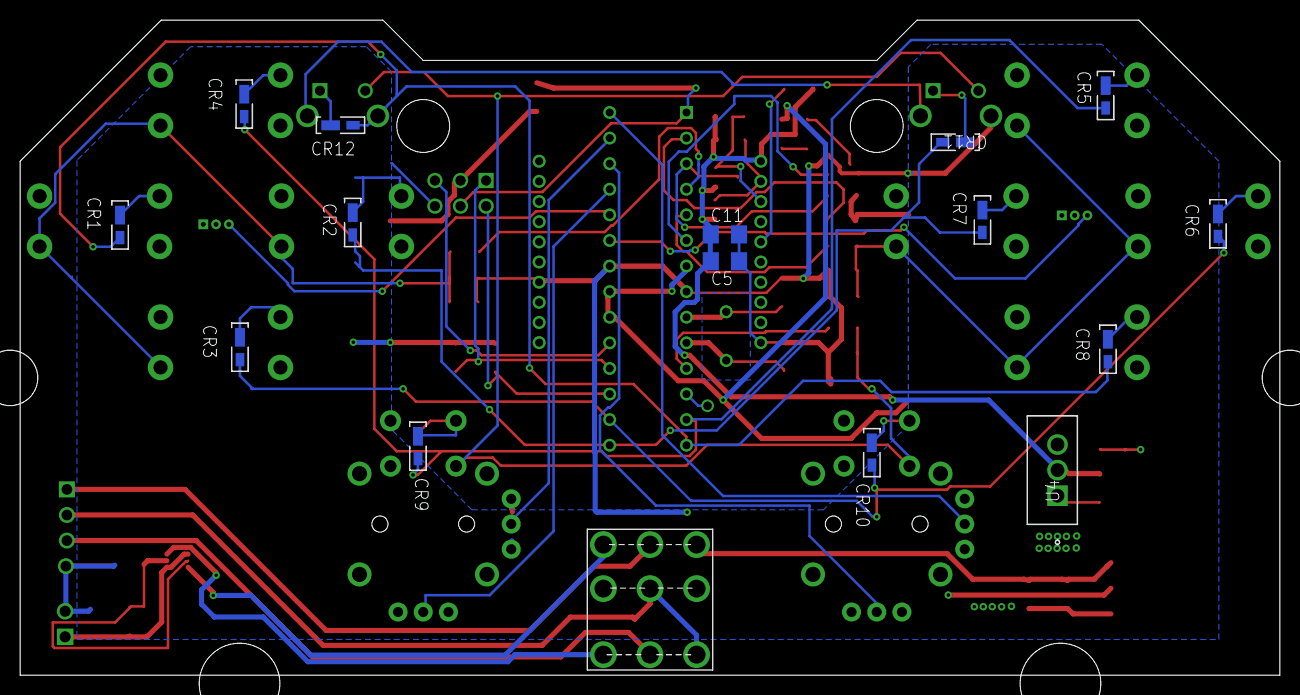
[picture p21: board Controller.brd from below]

Board: 2 copper layers, 125.0 x 65.0 mm, 70 parts (16 on the bottom side), 54 nets.
