sdsmt-robotics/Controller/(commit log)

2019-09-14 Added buttons and a switch
    [Controller.sch]
2019-09-15 Redid debounce filter and added unity gain buffer. Added Xbee and logic level shifter for RX and TX
    [Controller.sch]
2019-09-15 Added 16MHz oscillator for Atmega328p
    [Controller.brd]
2019-09-15 Fixed connection error in Low Pass filter
    [Controller.brd, Controller.sch]
2019-10-05 Update Controller.lbr
    Made a couple of changes to the board outline. Add zeners to the each button
2019-10-11 Added more holes, did some routing added 3D models
    [Controller.brd, Controller.sch, RKJXV1224005.STEP]
2019-10-11 MORE ROUTING!!
    [Controller.brd]
2019-10-12 Routing
    Routed most of the board. Need to add power components and Zeners
    [Controller.brd]
2019-10-19 Changes
    Added more 3D models. Changed to a ATMega2560
    [BSS138_D87Z--3DModel-STEP-56544.STEP, Controller.brd, Controller.sch, Tactal Switch - THRU(12mmx12mmx8mm)-Black.stp, Tactal Switch - THRU(12mmx12mmx8mm)-Blue.stp, Tactal Switch - THRU(12mmx12mmx8mm)-Brown.stp, Tactal Switch - THRU(12mmx12mmx8mm)-Green.stp, Tactal Switch - THRU(12mmx12mmx8mm)-Orange.stp]
2019-10-20 Added Charlieplexed button matrix
    Will now have to turn on PORTB bits 1:3
    [Controller.brd, Controller.sch]
2019-10-20 Added Hall effect sensors
2019-10-21 Redoing the board
    [Controller.brd, Controller.sch]
2019-10-24 Added Board
    [Controller.brd, TS3B-L.step, TS3B-M.step, TS3B.step]
2019-10-24 added 5V regulator
    Still need to add BMS circuitry and switch
    [Controller.brd, Controller.sch]
2019-10-28 rerouted so we only have 2 layers, added PWM pin
    Need to add battery switch,indicator Vbat pins
    [Controller.brd, Controller.sch]
2019-11-01 Added switch and LED
    [Controller.brd, Controller.sch]
2019-11-02 Added coherent BOM
    [Bom_8060896.xlsx, Controller.csv]
2019-11-03 Added diodes and made traces 10 mills
    [Controller.brd, Controller.sch]
2019-11-03 Minor Changes and added Gerber
    [Bom_8060896.xlsx, Controller.brd, Controller.csv, Controller_centroid.csv]
2019-11-04 Updated trace width for power
    All Power traces (VCC, +3V3 and 5V) are rated for 1.5A. All other traces are rated for 0.8A
    [Controller.brd]
2019-11-04 Added Gerbers
    [Controller.brd]
2019-11-04 Added Sam's holes
    [Controller.brd]
2019-11-04 Read Desc.
    * Moved Bumpers 3mm lower
    * changed TO diodes to SMD
    * Chnaged BOM to shorter actuator buttons
    [Controller BOM.csv, Controller.brd, Controller.csv, Controller.sch]
2019-11-21 Fixed overlap and deleted some stubs
    [Controller.brd]
2020-01-13 Fixed pin toggeling
    Had to NOT some bits to set the pin LOW
    [sketch_dec04a.ino]
2020-02-02 Update sketch_dec04a.ino
    Mostly working controller code. Still have to fix recieving more than one button press when only pressed once. Must also make sure hall effect sensors work.
    [sketch_dec04a.ino]
2020-02-29 Debounced buttons
    Hopefully, it's done and I don't need to adjust any delays
2020-03-01 FIxed
    Have Sam check
    [sketch_dec04a.ino]
2020-03-14 Fix missing joystick button in receive demo code
    [receive.ino]
2020-03-15 Improve data transmission and add some functions to clean up analog values
    * Increased xbee baudrate to 115200. Nothing has caught on fire yet...
    * Split full sends into two halves so we are less likely to overflow the serial buffer.
    * Added a joystick deadzone function to the receive code
    * Changed over to floats for analog values. Performance doesn't take that much of a hit, and it is much more usable.
    * Added some scaling to analog values for rev3.
    * Added some documentation for the rev3 code.
    [Controller.cpp, Controller.h, receive.ino, rev1.ino, rev3.ino]
2020-03-17 Add button debouncing to rev2 code
